PioBudny/Engineer-s-Thesis/README.md

# Engineer-s-Thesis
TDR project for my Engineer's Thesis
