PioBudny/Engineer-s-Thesis/Schematic.pdf

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
GPIO[3..0]

INTR
RESET

8T_OUT_1
8T_OUT_2

8TCLKP
8TCLKN

Poer/In&Out
TDR_Schematic_PB.SchDoc

SDA
SCL
GPIO[3..0]

RESET

8TCLKP
8TCLKN

8T_OUT_1
8T_OUT_2

INTR

MCU
8T49N241-999NLGI.SchDoc
Autor | Piotr Budny | Zmodyfikowano 14.05.2026 13:14:04

Temat pracy

Ark. główny
Ark. bieżący

/Altium/TDR/Main.SchDoc
Current Sheet

Promotor Dr. Inż. Maciej Urbański

Wersja *

Strona | Stron ogółem 1 | 3

Nr albumu 324985

Reflektometr do pomiarów parametrów linii długich

D D

C C

B B

A A

Autor | Piotr Budny | Zmodyfikowano 14.05.2026 13:14:04

Temat pracy

Current sheet

Wersja 1.1

Strona | Stron ogółem 2 | 3

Nr albumu 324985

Reflektometr do pomiarów parametrów linii długich

GND

Q0 | 1
Q0 | 2
Q1 | 3
Q1 | 4
GND | 5

D1 6

D0 7

VCC 8

U2 SN65EPT22DGKR

+3V3

TIMER_STM32

8T_CLK_N

8T_CLK_P

GND

GND
TIMER_STM32
SCL
SDA
GPIO0
GPIO1

GND

GND

GPIO2
GPIO3

GND
2

P1 1803426

IN 1
IN 2

EN/UV 3

ILIM | 5
OUT | 10
OUTS | 9
PG | 4
PGFB 6

SET 7

GND | 8
GND | 11

U1

LT3045EDD#PBF

GND

C1
10uF

GND

+5V

C3

DNM

GND

C2

### 10 uF

IN 1
IN 2

EN/UV 3

ILIM | 5
OUT | 10
OUTS | 9
PG | 4
PGFB 6

SET 7

GND | 8
GND | 11

U4

LT3045EDD#PBF

GND

C35
10uF

GND

+3V3

C41
DNM

GND

C36
10uF
GND | GND

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
P2 61300911121

1
2
3
4
5

J2

142-0701-851

4
5

J1

142-0701-851

1
2
3
4
5

J4

142-0701-851

D3 | D5 D4

GND

### 9 x AQ4020-01FTG

C5
10pF

C4
10pF

8T_OUT_1

ADC_CLK_N

ADC_CLK_P

ADC_CLK_P
ADC_CLK_N

R7
50

R8

### 50 R6

50

R9
100

R19
18.2K

R5
33.2K
D6 | D7 | D8 | D9 | D10 | D11

INTR
RESET

R18
0

R3
0

0V ... 0,8V

0V ... 0,8V

0V ... 1V

AC

AC

AC

### 50 Ω

50

### 50 Ω

Wyjście zegara do układu AD9515

Zanegowane wyjście zegara do układu AD9515

Wyjście reflektometru 350ps

R2
10k

R1
91k

0V ... 18V

GND

1
2
3
4
5

J3

142-0701-851

8T_OUT_2

0V ... 2,5V
AC 50

Wyjście reflektometru 240ps

1

4 3

Q1

DMP4015SK3-13

D2 TLMG¹¹⁰⁰⁻GS¹⁵

1

1

2

2

3

3
X1

Przełącznik włącz/wyłącz

C42

100uF

+5V

GND | GND

8TCLKP
8TCLKN
+1V8 | +3V3

8T_OUT_1

8T_OUT_2

SCL
SDA

INTR
RESET

GPIO[3..0]

D1

SMF5.0A-T13

C6
0.1uF

5MS1S102AM2QE

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
Kondensatory dołączone do dziur montażowych
MH1 | MH2 | MH3 | MH4

R4
1.2K

D D

C C

B B

A A

Autor | Piotr Budny | Zmodyfikowano 14.05.2026 13:14:04

Temat pracy

Current sheet

Wersja 1.1

Strona | Stron ogółem 3 | 3

Nr albumu 324985

Reflektometr do pomiarów parametrów linii długich

+3V3

+1V8

SDA
SCL

+3V3

INTR
RESET

+3V3

GND

GND

+3V3

C8
100pF

C10
100pF

C20
100pF

C22
100pF

C7
100pF

C9
100pF

C11
100pF

C21
100pF

GND

C24
10pF
Postawić blisko pinów VCC VCC ¹³ VCC ¹⁵ | VCCA

## 1 VCCA

### 2 VCCA 30 VCCA 32 VCCA 39 VCCCS 36

VCCO0 | 4
VCCO1 | 10
VCCO2 | 21
VCCO3 | 27

GPIO[0] 3

GPIO[1] 7

GPIO[2] 24 | GPIO[3] 28
*Q0 | 6
*Q1 | 8
*Q2 | 23
*Q3 | 25

CLK0 16

CLK1 18

NINT 29
NRST 31 | NWP 35

OSCI 33
OSCO 34
Q0 | 5
Q1 | 9
Q2 | 22
Q3 | 26
SCLK 12 | SDATA 11 | VEE 14

*CLK0 17

*CLK1 19

S_A0 40

S_A1 20 | CAP 37 CAP_REF 38 | EPAD 41

U3
8T49N241-998NLGI

GPIO3
GPIO2
GPIO1
GPIO0

R10
10K | R11
| 10K

R15
10K | R16
| 10K

ADDR: 0x7C+"S_A0"+"S_A1"

R13
DNM

R12
DNM

+3V3

C31
10pF

D12

TLMG1100-GS15

GND

+3V3

R17
600

R14
10K

GND

8TCLKP
8TCLKN

8T_OUT_1

8T_OUT_2

INTR
RESET

SDA
SCL

GPIO[3..0]

C27
10pF

C25
10pF

GND

Debug

Debug

+3V3

VCO1

VCO2

VCO3

C32

100pF

GND

C33

100pF

GND

C34

100pF

GND

VCO1 | VCO2 | VCO3

C16
0.1uF

C17
0.1uF

C18
0.1uF

C19
0.1uF

C15
0.1uF

C14
0.1uF

C13
0.1uF

C12
0.1uF

C28
0.1uF

C29
0.1uF

C38
0.1uF

C40
0.1uF

C37
0.1uF

+3V3

R21
0

R20
0

GND

NC XIN
XOUT NC

H130B-25.000-18-F-1030-EXT-TR X2
