PioBudny/Engineer-s-Thesis/Altium/TDR/TDR_BOM.xlsx

Name/Value | Description | Designator | Footprint/Package | Quantity | Manufacturer | Manufacturer Part Number | Supplier 1 | Supplier Part Number 1 | Supplier 2 | Supplier Part Number 2 | Supplier 3 | Supplier Part Number 4 | Remarks
10uF | Generic Capicitor | C1, C2 C35, C36 | SMD 0603 | 4 | KEMET | C0603C106M9PAC7411 | Mouser | 80-C0603C106M9P7411 | DigiKey | 399-C0603C106M9PAC7411TR-ND | Generic
DNM | Generic Capicitor | C3, C41 | SMD 0603 | 2 | DNM
10pF | Special Capicitor designed for high frequency | C4, C5, C24, C25, C27, C31 | SMD 0603 | 6 | KYOCERA AVX | KGQ15ACG2D100GT | Mouser | 581-KGQ15ACG2D100GT | DigiKey | 478-KGQ15ACG2D100GTTR-ND | arrow electronics | Cap Ceramic 10pF 200V C0G 2% Pad SMD 0603 125°C T/R
100nF | Low ESR Decoupling capacitor | C6, C12, C13, C14, C15, C16, C17, C18, C19,C28, C29, C37, C38, C40 C42 | SMD 0603 | 14 | KYOCERA AVX | KGM15AR70J104KT | Mouser | 581-KGM15AR70J104KT | DigiKey | 478-KGM15AR70J104KTTR-ND - | Generic Low ESR
100pF | Low ESR Decoupling capacitor | C7, C8, C9, C10, C11, C20, C21, C22, C32, C33, C34, | SMD 0603 | 11 | KYOCERA AVX | KGM15ACG2A101JM | Mouser | 581-KGM15ACG2A101JM | ElectroMaker | Multilayer Ceramic Capacitors MLCC - SMD/SMT 100V 100pF C0G 0603 5% | Generic Low ESR
100uF | THT bulk capacitor | C42 | THT | 1 | Kemet | ESK107M025AC3AA | Mouser | 80-ESK107M025AC3AA | DigiKey | 399-6102-ND | Newark | 87AC7446
SMF5.0A-T13 | TVS Diode (Uni-directional) | D1 | SOD-123-2 | 1 | Littelfuse | SMF5.0A-T13 | Mouser | 576-SMF5.0A-T13 | DigiKey | 18-SMF5.0A-T13TR-ND | Farnell | 2691565
TLMG1100-GS15 | Standard LEDs - SMD CHIPLED(SMD 0603-LED) GREEN U.BRIGHT-E4 | D2, D12 | SMD 0603 | 2 | Vishay | TLMG1100-GS15 | Mouser | 78-TLMG1100-GS15 | DigiKey | 751-TLMG1100-GS15TR-ND | TME | TLMG1100-GS15
AQ4020-01FTG | TVS Diode (Uni-directional) | D3, D4, D5, D6, D7, D8, D9, D10, D11 | SOD-323-2 | 9 | Littelfuse | AQ4020-01FTG | Mouser | 576-AQ4020-01FTG | DigiKey | F10395TR-ND | Arrow Electronics | ESD Suppressor Diode TVS Bi-Dir 3.3V 24.5Vc Automotive AEC-Q101 2-Pin SOD-323 T/R
142-0701-851 | SMA connector straight | J1, J2, J3, J4 | THT | 4 | 530-142-0701-851 | Cinch Connectivity Solutions | Available/DNM
DNM | Generic Capicitor | MH1, MH2, MH3, MH4 | SMD 0805 | 4 | DNM
1803426 | Male Header, Pitch 3.81 mm, 1 x 2 Position, Height 9.2 mm, Tail Length 3.4 mm | P1 | THT 3.8mm | 1 | Phoenix Contact | 1803426 | Mouser | 651-1803426 | DigiKey | 277-1221-ND | TME | MCV1.5/2-G-3.81
61300911121 | Generic THT Vertical Pin Header WR-PHD, Pitch 2.54 mm, Single Row, 9 pins | P2 | THT 2.54mm | 1 | Wurth Elektronik | 61300911121 | Mouser | 710-61300911121 | Farnell | 2356161 | Generic Goldpins 2.54mm rastr 9-10 pins
DMP4015SK3-13 | P-channel MOSFET transistor | Q1 | TO-252 | 1 | Diodes Incorporated | DMP4015SK3-13 | Mouser | 621-DMP4015SK3-13 | DigiKey | DMP4015SK3-13DITR-ND | Farnell | 2543554
91k | Generic Resistor | R1 | SMD 0805 | 1 | YAGEO | RC0805FR-0791KL | Mouser | 603-RC0805FR-0791KL | DigiKey | 311-91.0KCRTR-ND - Tape & Reel | Generic Resistor
0 | Generic Resistor | R3, R18, R20, R21 | SMD 0805 | 4 | YAGEO | AC0805FR-070RL | Mouser | 603-AC0805FR-070RL | DigiKey | 13-AC0805FR-070RLTR-ND | Generic Resistor
1.2K | Generic Resistor | R4 | SMD 0805 | 1 | YAGEO | AC0805FR-071K2L | Mouser | 603-AC0805FR-071K2L | DigiKey | YAG3700TR-ND | Generic Resistor
33.2K | Generic Resistor | R5 | SMD 0805 | 1 | YAGEO | AC0805FR-0733K2L | Mouser | 603-AC0805FR-0733K2L | DigiKey | 13-AC0805FR-0733K2LTR-ND | Generic Resistor
50 | Generic Resistor | R6, R7, R8 | SMD 0603 | 3 | Vishay Dale | RCP0603W50R0GEB | Mouser | 71-RCP0603W50R0GEB | DigiKey | 541-2655-2-ND | Generic Resistor
100 | Generic Resistor | R9 | SMD 0603 | 1 | YAGEO | RC0603FR-07100RL | Mouser | 603-RC0603FR-07100RL | DigiKey | 311-100HRTR-ND | Generic Resistor
10K | Generic Resistor | R2, R10, R11, R14, R15, R16 | SMD 0805 | 5 | YAGEO | RC0805FR-0710KL | Mouser | 603-RC0805FR-0710KL | DigiKey | 311-10.0KCRTR-ND | Generic Resistor
DNM | Generic Resistor | R12, R13 | SMD 0805 | 2 | DNM
600 | Generic Resistor | R17 | SMD 0603 | 1 | YAGEO | AC0603FR-07604RL | Mouser | 603-AC0603FR-07604RL | DigiKey | 13-AC0603FR-07604RLTR-ND | Generic Resistor
18.2K | Generic Resistor | R19 | SMD 0805 | 1 | YAGEO | RC0805FR-0718K2L | Mouser | 603-RC0805FR-0718K2L | DigiKey | 311-18.2KCRTR-ND | Generic Resistor
LT3045EDD#PBF | IC REG LINEAR 0V 500MA 10DFN | U1, U4 | DFN-10 | 2 | Analog Devices | LT3045EDD#PBF | Mouser | 584-LT3045EDD#PBF | DigiKey | 505-LT3045IDD#TRPBFTR-ND | Worldway Electronics | LT3045EDD#PBF-10484781
SN65EPT22DGKR | 4000 Mbps 3.3 V Dual LVTTL / LVCMOS to Differential LVPECL Buffer, 2 Tx and 2 Rx, -40 to +85 degC, 8-pin VSSOP (DGK), Green (RoHS & no Sb/Br) | U2 | 8-TSSOP | 1 | Texas Instruments | SN65EPT22DGKR | Mouser | 595-SN65EPT22DGKR | DigiKey | 296-46326-1-ND | Texas Industries | SN65EPT22DGKR
8T49N241-999NLGI | Tin Active e3 CLOCK GENERATOR OTHER (Type) IC 18Weeks -40C 6mm 1GHz | U3 | 40-VFQFN | 1 | Renesans electronics | 8T49N241-998NLGI | Mouser | 972-8T49N241-998NLGI | Farnell | 3251297 | RS | 8T49N241-998NLGI
5MS1S102AM2QE | Switch: Slide; Positions: 2; SPDT; 2A/250VAC; 5A/28VDC; ON-ON | X1 | THT 4.7mm | 1 | LIGHT COUNTRY CO., LTD | 5MS1S102AM2QE | TME | 5MS1S102AM2QE | Mouser | 118-5MS1S102AM2QES | Generic SPDT switch with 4.7mm raster and at least 5A/20V
H130B-25.000-12-F-EXT-TR | Crystal 25MHZ, 12pF 30, mohm | X2 | SMD | 1 | Raltron Electronics | H130B-25.000-12-F-EXT-TR | DigiKey | 2151-H130B-25.000-12-F-EXT-TR-ND | Newark | H130B-25.000-12-F-EXT-TR | - | -
