PioBudny/Engineer-s-Thesis/TEST/Newfile1.csv

X | CH1 | Start | Increment
Sequence | Volt | -7.000000e-08 | 1.000000e-10
0 | -4.687500e-01
1 | -4.687500e-01
2 | -4.687500e-01
3 | -4.687500e-01
4 | -3.125000e-01
5 | -3.125000e-01
6 | -3.125000e-01
7 | -3.125000e-01
8 | -4.687500e-01
9 | -4.687500e-01
10 | -3.125000e-01
11 | -3.125000e-01
12 | -4.687500e-01
13 | -4.687500e-01
14 | -4.687500e-01
15 | -4.687500e-01
16 | -3.125000e-01
17 | -3.125000e-01
18 | -4.687500e-01
19 | -4.687500e-01
20 | -4.687500e-01
21 | -4.687500e-01
22 | -4.687500e-01
23 | -4.687500e-01
24 | -4.687500e-01
25 | -4.687500e-01
26 | -4.687500e-01
27 | -4.687500e-01
28 | -4.687500e-01
29 | -4.687500e-01
30 | -4.687500e-01
31 | -4.687500e-01
32 | -3.125000e-01
33 | -3.125000e-01
34 | -3.125000e-01
35 | -3.125000e-01
36 | -4.687500e-01
37 | -4.687500e-01
38 | -4.687500e-01
39 | -4.687500e-01
40 | -4.687500e-01
41 | -4.687500e-01
42 | -4.687500e-01
43 | -4.687500e-01
44 | -4.687500e-01
45 | -4.687500e-01
46 | -4.687500e-01
47 | -4.687500e-01
48 | -4.687500e-01
49 | -4.687500e-01
50 | -4.687500e-01
51 | -4.687500e-01
52 | -6.250000e-01
53 | -6.250000e-01
54 | -4.687500e-01
55 | -4.687500e-01
56 | -4.687500e-01
57 | -4.687500e-01
58 | -4.687500e-01
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
