PioBudny/Engineer-s-Thesis/TEST/TDR_pulse_50-120-50_open_1.csv

X | CH1 | Start | Increment
Sequence | Volt | -2.000000e-10 | 1.000000e-11
0 | 0.000000e+00
1 | 0.000000e+00
2 | 0.000000e+00
3 | 0.000000e+00
4 | 0.000000e+00
5 | 0.000000e+00
6 | 0.000000e+00
7 | 0.000000e+00
8 | 0.000000e+00
9 | 0.000000e+00
10 | 0.000000e+00
11 | 0.000000e+00
12 | 0.000000e+00
13 | 0.000000e+00
14 | 0.000000e+00
15 | 0.000000e+00
16 | 0.000000e+00
17 | 0.000000e+00
18 | 0.000000e+00
19 | 0.000000e+00
20 | 0.000000e+00
21 | 7.500000e-02
22 | 1.500000e-01
23 | 2.250000e-01
24 | 3.000000e-01
25 | 3.750000e-01
26 | 4.500000e-01
27 | 5.250000e-01
28 | 6.000000e-01
29 | 6.750000e-01
30 | 7.500000e-01
31 | 8.250000e-01
32 | 9.000000e-01
33 | 9.750000e-01
34 | 1.050000e+00
35 | 1.125000e+00
36 | 1.200000e+00
37 | 1.275000e+00
38 | 1.350000e+00
39 | 1.425000e+00
40 | 1.500000e+00
41 | 1.425000e+00
42 | 1.350000e+00
43 | 1.275000e+00
44 | 1.200000e+00
45 | 1.125000e+00
46 | 1.050000e+00
47 | 9.750000e-01
48 | 9.000000e-01
49 | 8.250000e-01
50 | 7.500000e-01
51 | 6.750000e-01
52 | 6.000000e-01
53 | 5.250000e-01
54 | 4.500000e-01
55 | 3.750000e-01
56 | 3.000000e-01
57 | 2.250000e-01
58 | 1.500000e-01
59 | 7.500000e-02
60 | 3.330669e-16
61 | 0.000000e+00
62 | 0.000000e+00
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
