PioBudny/Engineer-s-Thesis/TEST/test1.csv

X | CH1 | Start | Increment
Sequence | Volt | -1.919999e-09 | 2.000000e-11
0 | -4.687500e-01
1 | -4.687500e-01
2 | -4.687500e-01
3 | -4.687500e-01
4 | -4.687500e-01
5 | -4.687500e-01
6 | -4.687500e-01
7 | -4.687500e-01
8 | -4.687500e-01
9 | -4.687500e-01
10 | -4.687500e-01
11 | -4.687500e-01
12 | -4.687500e-01
13 | -4.687500e-01
14 | -4.687500e-01
15 | -4.687500e-01
16 | -4.687500e-01
17 | -4.687500e-01
18 | -4.687500e-01
19 | -4.687500e-01
20 | -4.687500e-01
21 | -4.687500e-01
22 | -4.687500e-01
23 | -4.687500e-01
24 | -4.687500e-01
25 | -4.687500e-01
26 | -4.687500e-01
27 | -4.687500e-01
28 | -6.250000e-01
29 | -6.250000e-01
30 | -6.250000e-01
31 | -6.250000e-01
32 | -6.250000e-01
33 | -6.250000e-01
34 | -6.250000e-01
35 | -6.250000e-01
36 | -6.250000e-01
37 | -6.250000e-01
38 | -6.250000e-01
39 | -6.250000e-01
40 | -6.250000e-01
41 | -6.250000e-01
42 | -6.250000e-01
43 | -6.250000e-01
44 | -6.250000e-01
45 | -6.250000e-01
46 | -6.250000e-01
47 | -6.250000e-01
48 | -6.250000e-01
49 | -6.250000e-01
50 | -6.250000e-01
51 | -6.250000e-01
52 | -6.250000e-01
53 | -6.250000e-01
54 | -6.250000e-01
55 | -6.250000e-01
56 | -6.250000e-01
57 | -6.250000e-01
58 | -6.250000e-01
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
