PioBudny/Engineer-s-Thesis/TEST/test3.csv

X | CH1 | Start | Increment
Sequence | Volt | -1.440000e-08 | 5.000000e-11
0 | -3.125000e-01
1 | -3.125000e-01
2 | -3.750000e-01
3 | -3.750000e-01
4 | -3.125000e-01
5 | -3.125000e-01
6 | -3.125000e-01
7 | -3.125000e-01
8 | -3.125000e-01
9 | -3.125000e-01
10 | -3.125000e-01
11 | -3.125000e-01
12 | -3.750000e-01
13 | -3.750000e-01
14 | -3.125000e-01
15 | -3.125000e-01
16 | -3.750000e-01
17 | -3.750000e-01
18 | -3.750000e-01
19 | -3.750000e-01
20 | -3.750000e-01
21 | -3.750000e-01
22 | -3.750000e-01
23 | -3.750000e-01
24 | -3.750000e-01
25 | -3.750000e-01
26 | -3.750000e-01
27 | -3.750000e-01
28 | -3.750000e-01
29 | -3.750000e-01
30 | -3.750000e-01
31 | -3.750000e-01
32 | -3.750000e-01
33 | -3.750000e-01
34 | -3.750000e-01
35 | -3.750000e-01
36 | -3.750000e-01
37 | -3.750000e-01
38 | -3.750000e-01
39 | -3.750000e-01
40 | -3.125000e-01
41 | -3.125000e-01
42 | -3.750000e-01
43 | -3.750000e-01
44 | -3.125000e-01
45 | -3.125000e-01
46 | -3.125000e-01
47 | -3.125000e-01
48 | -3.125000e-01
49 | -3.125000e-01
50 | -3.125000e-01
51 | -3.125000e-01
52 | -3.750000e-01
53 | -3.750000e-01
54 | -3.125000e-01
55 | -3.125000e-01
56 | -3.750000e-01
57 | -3.750000e-01
58 | -3.750000e-01
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
