PioBudny/Engineer-s-Thesis/(list of files, drawings)

Other design files:
Altium/TDR/8T49N241-999NLGI.SchDoc
Altium/TDR/Main.SchDoc
Altium/TDR/TDR3.PcbDoc
Altium/TDR/TDR.PrjPcb
Altium/TDR/TDR_PCB_1.PcbLib
Altium/TDR/TDR_Sch_1.SchLib
Altium/TDR/TDR_Schematic_PB.SchDoc
Altium/TDR/Test.PcbDoc
