PioBudny/Engineer-s-Thesis/TDR_software/src/8T49N241/8T49N241.c

#include "8T49N241.h"
#include "pico/stdlib.h"
#include <stdlib.h>
#include <stdio.h>
#include <string.h>

void i2c_device_init(i2c_inst_t *i2c, uint sda, uint scl) {
    i2c_init(i2c, 400 * 1000);
    gpio_set_function(sda, GPIO_FUNC_I2C);
    gpio_set_function(scl, GPIO_FUNC_I2C);
    gpio_pull_up(sda);
    gpio_pull_up(scl);

    sleep_ms(200);
}


bool i2c_write_reg16(i2c_inst_t *i2c, uint8_t addr, uint16_t reg, uint8_t *data, size_t len) {
    uint8_t buffer[258];

    buffer[0] = (reg >> 8) & 0xFF;
    buffer[1] = reg & 0xFF;

    for (size_t i = 0; i < len; i++) {
        buffer[2 + i] = data[i];
    }

    int ret = i2c_write_timeout_us(i2c, addr, buffer, len + 2, false, 1000000); // 1s timeout
    return (ret >= 0);
}


bool i2c_read_reg16(i2c_inst_t *i2c, uint8_t addr, uint16_t reg, uint8_t *data, size_t len) {
    uint8_t reg_buf[2];

    reg_buf[0] = (reg >> 8) & 0xFF;
    reg_buf[1] = reg & 0xFF;

    // ustaw adres rejestru
    if (i2c_write_timeout_us(i2c, addr, reg_buf, 2, true, 1000000) < 0) { // 1s timeout
        return false;
    }

    // czytaj dane
    if (i2c_read_timeout_us(i2c, addr, data, len, false, 1000000) < 0) { // 1s timeout
        return false;
    }

    return true;
}

const NLG_cfg_t Default_values[] =
{
    {0x0000, 0x09},
    {0x0001, 0x50},
  
    {0x0008, 0x03},
    {0x0009, 0x00},
    {0x000A, 0x31},
    {0x000B, 0x00},
    {0x000C, 0x00},
    {0x000D, 0x00},
    {0x000E, 0x00},
    {0x000F, 0x00},
    {0x0010, 0x01},
    {0x0011, 0x00},
    {0x0012, 0x00},
    {0x0013, 0x00},
    {0x0014, 0x07},
    {0x0015, 0x00},
    {0x0016, 0x00},
    {0x0017, 0x77},
    {0x0018, 0x6D},
    {0x0019, 0x00},
    {0x001A, 0x00},
    {0x001B, 0x00},
    {0x001C, 0x00},
    {0x001D, 0x00},
    {0x001E, 0x00},
    {0x001F, 0xFF},
    {0x0020, 0xFF},
    {0x0021, 0xFF},
    {0x0022, 0xFF},
    {0x0023, 0x03},
    {0x0024, 0x3F},
    {0x0025, 0x00},
    {0x0026, 0x46},

    {0x0027, 0x00},
    {0x0028, 0x00},
    {0x0029, 0x00},
    {0x002A, 0x00},
    {0x002B, 0x00},
    {0x002C, 0x01},
    {0x002D, 0x00},
    {0x002E, 0x00},
    {0x002F, 0xD0},
    {0x0030, 0x00},
    {0x0031, 0x00},
    {0x0032, 0x00},
    {0x0033, 0x00},
    {0x0034, 0x00},
    {0x0035, 0x00},
    {0x0036, 0x00},
    {0x0037, 0x00},
    {0x0038, 0x00},

    {0x003A, 0x00},
    {0x003B, 0x00},
    {0x003C, 0x00},
    {0x003D, 0x66},
    {0x003E, 0x66},
    {0x003F, 0x00},
    {0x0040, 0x00},
    {0x0041, 0x03},
    {0x0042, 0x00},
    {0x0043, 0x00},
    {0x0044, 0x03},
    {0x0045, 0x00},
    {0x0046, 0x04},
    {0x0047, 0xE2},

    {0x0048, 0x00},
    {0x0049, 0x04},
    {0x004A, 0xE2},

    {0x004B, 0x00},
    {0x004C, 0x00},
    {0x004D, 0x00},
    {0x004E, 0x00},
    {0x004F, 0x00},
    {0x0050, 0x00},
    {0x0051, 0x00},
    {0x0052, 0x00},
    {0x0053, 0x00},
    {0x0054, 0x00},
    {0x0055, 0x00},
    {0x0056, 0x00},
    {0x0057, 0x00},
    {0x0058, 0x00},
    {0x0059, 0x00},
    {0x005A, 0x00},
    {0x005B, 0x00},
    {0x005C, 0x00},
    {0x005D, 0x00},
    {0x005E, 0x00},
    {0x005F, 0x00},
    {0x0060, 0x00},
    {0x0061, 0x00},
    {0x0062, 0x00},
    {0x0063, 0x33},

    {0x0064, 0x00},
    {0x0065, 0x00},
    {0x0066, 0x00},
    {0x0067, 0x00},
    {0x0068, 0xE8},
    {0x0069, 0x0A},

    {0x006A, 0x2B},
    {0x006B, 0x20},
    {0x006C, 0x00},
    {0x006D, 0x03},
    {0x006E, 0x00},
    {0x006F, 0x03},

    {0x0070, 0x00},
    {0x0071, 0x00},
    {0x0072, 0x00},
    {0x0072, 0x17},
    {0x0073, 0x17},
    {0x0074, 0x00},
    {0x0075, 0x00},
    {0x0076, 0x00},
    {0x0077, 0x00},
    {0x0078, 0x00},
    {0x0079, 0x00},

    {0x007A, 0x27},
    {0x007B, 0xCC},
    {0x0200, 0x73},
};

const NLG_cfg_t Debug_values[] =
{
    {0x0000, 0x09},
    {0x0001, 0x50},
    {0x0002, 0x00},
    {0x0003, 0x60},
    {0x0004, 0x67},
    {0x0005, 0xCF},
    {0x0006, 0x7C},
    {0x0007, 0x01},
    {0x0008, 0x03},
    {0x0009, 0x00},
    {0x000A, 0x31},
    {0x000B, 0x00},
    {0x000C, 0x00},
    {0x000D, 0x00},
    {0x000E, 0x00},
    {0x000F, 0x00},
    {0x0010, 0x01},
    {0x0011, 0x00},
    {0x0012, 0x00},
    {0x0013, 0x00},
    {0x0014, 0x07},
    {0x0015, 0x00},
    {0x0016, 0x00},
    {0x0017, 0x77},
    {0x0018, 0x6D},
    {0x0019, 0x00},
    {0x001A, 0x00},
    {0x001B, 0x00},
    {0x001C, 0x00},
    {0x001D, 0x00},
    {0x001E, 0x00},
    {0x001F, 0xFF},
    {0x0020, 0xFF},
    {0x0021, 0xFF},
    {0x0022, 0xFF},
    {0x0023, 0x03},
    {0x0024, 0x3F},
    {0x0025, 0x00},
    {0x0026, 0x46},
    {0x0027, 0x00},
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
};

const size_t Debug_values_count = sizeof(Debug_values) / sizeof(Debug_values[0]);
const size_t Default_values_count = sizeof(Default_values) / sizeof(Default_values[0]);

void Flag_Clear(i2c_inst_t *i2c)
{
    uint8_t clr = 0x73;
    i2c_write_reg16(i2c, DEVICE_ADDR, REG_INT_STATUS_0, &clr, 1);
}

void dump_all_regs(i2c_inst_t *i2c)
{
    uint8_t data;

    printf("\n==============================\n");
    printf("8T49N241 regs:\n");
    printf("==============================\n");


    // ========================================
    // REJESTRY KONFIGURACYJNE
    // 0x0000 - 0x007B
    // ========================================

    for(uint16_t reg = 0x0000;
        reg <= 0x007B;
        reg++)
    {
        if(i2c_read_reg16(
            i2c,
            DEVICE_ADDR,
            reg,
            &data,
            1
        ))
        {
            printf(
                "REG[0x%04X] = 0x%02X\n",
                reg,
                data
            );
        }
        else
        {
            printf(
                "REG[0x%04X] = READ ERROR\n",
                reg
            );
        }

        sleep_us(100);
    }


    // ========================================
    // REJESTRY STATUSOWE
    // 0x0200 - 0x0212
    // ========================================

    printf("\nSTATUS REGS\n\n");

    for(uint16_t reg = 0x0200;
        reg <= 0x0212;
        reg++)
    {
        if(i2c_read_reg16(
            i2c,
            DEVICE_ADDR,
            reg,
            &data,
            1
        ))
        {
            printf(
                "REG[0x%04X] = 0x%02X\n",
                reg,
                data
            );
        }
        else
        {
            printf(
                "REG[0x%04X] = READ ERROR\n",
                reg
            );
        }

        sleep_us(100);
    }
}


bool load_tab(i2c_inst_t *i2c, const NLG_cfg_t *cfg, size_t count)
{
    printf("Loading config...\n");

    for (size_t i = 0; i < count; i++)
    {
        uint16_t reg = cfg[i].reg;
        uint8_t value = cfg[i].value;

        // Próba zapisu rejestru
        if (!i2c_write_reg16(i2c, DEVICE_ADDR, reg, &value, 1))
        {
            sleep_ms(2); 
            if (!i2c_write_reg16(i2c, DEVICE_ADDR, reg, &value, 1)) {
                printf("Skip reg 0x%04X\n", reg);
                continue;
            }
        }


    }

    printf("Config loaded successfully\n");
    sleep_ms(10);
    return true;
}
