PioBudny/Engineer-s-Thesis/TDR_software/src/Impedance_wave.py

import tkinter as tk
import csv
import bisect
from pathlib import Path
from tkinter import filedialog, messagebox
from tkinter import ttk

SCOPE_RIGOL = "DS4052 Rigol"
SCOPE_RS = "RTO2044 Rohde&Schwarz"


def detect_trigger_index(values):
    """Auto-detects which sample corresponds to the scope's trigger point
    (t=0): the peak of the first pulse that rises clearly above the
    baseline noise. Used when compiling a raw .wfm.csv (one voltage value
    per line, no timing info) from the RTO2044 into the .csv format this
    calculator expects."""

    def average(nums):
        return sum(nums) / len(nums)

    prelim_count = max(3, int(len(values) * 0.05))
    prelim_offset = average(values[:prelim_count])
    corrected = [v - prelim_offset for v in values]
    noise = average([abs(v) for v in corrected[:prelim_count]])
    peak = max(abs(v) for v in corrected)
    threshold = max(noise * 6, peak * 0.1, 1e-12)

    start_index = None
    for i, v in enumerate(corrected):
        if abs(v) >= threshold:
            start_index = i
            break
    if start_index is None:
        return 0

    peak_index = start_index
    peak_magnitude = abs(corrected[start_index])
    for i in range(start_index, len(corrected)):
        magnitude = abs(corrected[i])
        if magnitude < threshold:
            break
        if magnitude > peak_magnitude:
            peak_magnitude = magnitude
            peak_index = i

    return peak_index


def Impedance_Wave(root, close_impedance_window):
    root.update_idletasks()
    root_x = root.winfo_x()
    root_y = root.winfo_y()
    root_w = root.winfo_width()

    impedance_window = tk.Toplevel(root)
    impedance_window.title("Impedance Calculator")
    impedance_window.geometry(f"1100x620+{root_x + root_w + 10}+{root_y}")
    impedance_window.protocol("WM_DELETE_WINDOW", close_impedance_window)

    # ────────────────────────────────────────────────────────────────
    # Górny pasek
    # ────────────────────────────────────────────────────────────────

    top_frame = tk.Frame(impedance_window)
    top_frame.pack(fill=tk.X, padx=10, pady=8)
    top_frame.columnconfigure(0, weight=1)

    csv_frame = tk.Frame(top_frame)
    csv_frame.grid(row=0, column=0, sticky="new", padx=(0, 10), pady=(0, 4))

    csv_path = tk.StringVar()
    z0_var = tk.StringVar(value="50")
    param_type_var = tk.StringVar(value="VF")
    param_value_var = tk.StringVar(value="")
    scope_var = tk.StringVar(value=SCOPE_RIGOL)
    rto_increment_var = tk.StringVar()
    raw_selected_path_var = tk.StringVar()  # file picked via Browse, before any RTO2044 compiling

    tk.Label(csv_frame, text="CSV file:").pack(side=tk.LEFT)

    tk.Entry(
        csv_frame,
        textvariable=csv_path
    ).pack(side=tk.LEFT, fill=tk.X, expand=True, padx=5)

    def prompt_rto_increment(blocking=False):
        prompt = tk.Toplevel(impedance_window)
        prompt.title("RTO2044 Increment")
        prompt.geometry("280x110")

        tk.Label(prompt, text="Increment (ps):", anchor="w").pack(fill=tk.X, padx=10, pady=(10, 4))
        entry_var = tk.StringVar(value=rto_increment_var.get())
        entry = tk.Entry(prompt, textvariable=entry_var)
        entry.pack(fill=tk.X, padx=10)
        entry.focus_set()

        def confirm():
            rto_increment_var.set(entry_var.get())
            prompt.destroy()

        tk.Button(prompt, text="OK", command=confirm).pack(pady=10)
        prompt.protocol("WM_DELETE_WINDOW", prompt.destroy)

        if blocking:
            prompt.grab_set()
            impedance_window.wait_window(prompt)

    def compile_wfm_to_csv(wfm_filename, increment_s):
        """Converts a raw .wfm.csv (one voltage value per line, no timing
        info) into the .csv format this calculator expects, writing it next
        to the source file. Raises OSError/ValueError on failure."""
        with open(wfm_filename, newline="") as wfm_file:
            raw_lines = [line.strip() for line in wfm_file if line.strip()]

        if not raw_lines:
            raise ValueError("The .wfm.csv file contains no data.")

        try:
            values = [float(v) for v in raw_lines]
        except ValueError:
            raise ValueError("The .wfm.csv file must contain one numeric value per line.")

        # Sample 0 in the file isn't necessarily t=0 - the scope's trigger
        # (t=0) usually sits somewhere in the middle of the capture, with
        # pre-trigger samples before it. Detect it automatically from the
        # waveform instead of asking for it.
        trigger_index = detect_trigger_index(values)
        start_s = -trigger_index * increment_s

        wfm_file_path = Path(wfm_filename)
        output_name = wfm_file_path.name
        if output_name.lower().endswith(".wfm.csv"):
            output_name = output_name[: -len(".wfm.csv")] + ".csv"
        else:
            output_name = wfm_file_path.stem + ".csv"
        output_path = wfm_file_path.parent / output_name

        with open(output_path, "w", newline="") as out_file:
            writer = csv.writer(out_file)
            writer.writerow(["X", "CH1", "Start", "Increment", ""])
            writer.writerow(["Sequence", "Volt", f"{start_s:.6e}", f"{increment_s:.6e}", ""])
            for index, value in enumerate(raw_lines):
                writer.writerow([index, value, ""])

        return output_path

    def load_from_scope(source_path):
        """Prepares source_path for loading according to the currently
        selected oscilloscope. For RTO2044 this asks for the increment
        (only here, right before it's needed) and compiles the raw
        .wfm.csv. Returns the path to actually load, or None on
        failure/cancel."""
        if scope_var.get() != SCOPE_RS:
            return source_path

        if not rto_increment_var.get().strip():
            prompt_rto_increment(blocking=True)

        try:
            increment_ps = float(rto_increment_var.get())
        except ValueError:
            messagebox.showerror("Invalid increment", "Increment (ps) must be numeric.")
            return None

        try:
            output_path = compile_wfm_to_csv(source_path, increment_ps * 1e-12)
        except (OSError, ValueError) as e:
            messagebox.showerror(".wfm.csv error", str(e))
            return None

        return str(output_path)

    def browse_csv():
        # File first, oscilloscope second - Browse doesn't need to know
        # which scope produced the file; that's decided when Load .csv
        # runs, based on whatever is selected in the scope list at that time.
        filename = filedialog.askopenfilename(
            title="Select measurement file",
            filetypes=[
                ("CSV files", "*.csv"),
                ("WFM CSV files", "*.wfm.csv"),
                ("All files", "*.*"),
            ],
        )

        if filename:
            raw_selected_path_var.set(filename)
            csv_path.set(filename)

    settings_frame = tk.Frame(top_frame)
    settings_frame.grid(row=1, column=0, sticky="new", padx=(0, 10))

    tk.Label(settings_frame, text="Z0 (Ohm):").pack(side=tk.LEFT)
    tk.Entry(settings_frame, textvariable=z0_var, width=8).pack(side=tk.LEFT, padx=(4, 12))

    tk.Label(settings_frame, text="Parameter:").pack(side=tk.LEFT, padx=(12, 4))

    def on_param_type_change(event=None):
        param_value_var.set("")

    param_combo = ttk.Combobox(
        settings_frame,
        textvariable=param_type_var,
        values=["VF", "ER"],
        state="readonly",
        width=6
    )
    param_combo.pack(side=tk.LEFT, padx=(0, 8))
    param_combo.bind("<<ComboboxSelected>>", on_param_type_change)

    tk.Entry(settings_frame, textvariable=param_value_var, width=8).pack(side=tk.LEFT, padx=(0, 12))

    variables_text = (
        "Z0 - reference impedance, VF - velocity factor (0-1), ER - relative permittivity (>1). "
    )
    tk.Label(
        settings_frame,
        text=variables_text,
        anchor="w",
        justify=tk.LEFT,
        wraplength=520
    ).pack(side=tk.LEFT, fill=tk.X, expand=True)
    
    
    # ────────────────────────────────────────────────────────────────
    # Vf/ER conversion
    # ────────────────────────────────────────────────────────────────
    def param_to_vf(param_type, value):
        if param_type == "VF":
            vf = value
            if vf > 1:
                vf /= 100
            if not (0 < vf <= 1):
                raise ValueError("VF must be between 0 and 1, or percent value like 66.")
            return vf
        else:  # ER
            er = value
            if er <= 1:
                raise ValueError("ER must be greater than 1.")
            return 1.0 / (er ** 0.5)
        
        
    # ────────────────────────────────────────────────────────────────
    # How To Use
    # ────────────────────────────────────────────────────────────────
    
    howto_text = (
        "How to use: 1) Browse and select the file  →  2) select the "
        "oscilloscope that produced it (DS4052 Rigol or RTO2044 "
        "Rohde&Schwarz)  →  3) Load .csv  →  4) set Z0 and VF/ER (add "
        "segments on the right if the cable has different sections)  →  "
        "5) Calculate Z(d)."
    )
    tk.Label(
        impedance_window,
        text=howto_text,
        anchor="w",
        justify=tk.LEFT,
        fg="gray",
        wraplength=1080
    ).pack(fill=tk.X, padx=10, pady=(0, 8))


    info_var = tk.StringVar(value="")

    content_frame = tk.Frame(impedance_window)
    content_frame.pack(fill=tk.BOTH, expand=True, padx=10, pady=(0, 10))

    charts_frame = tk.Frame(content_frame)
    charts_frame.pack(side=tk.LEFT, fill=tk.BOTH, expand=True)

    raw_chart_frame = tk.Frame(charts_frame, relief=tk.SUNKEN, borderwidth=1)
    raw_chart_frame.pack(side=tk.LEFT, fill=tk.BOTH, expand=True, padx=(0, 5))

    impedance_chart_frame = tk.Frame(charts_frame, relief=tk.SUNKEN, borderwidth=1)
    impedance_chart_frame.pack(side=tk.LEFT, fill=tk.BOTH, expand=True, padx=(5, 0))

    raw_canvas = tk.Canvas(raw_chart_frame, bg="white")
    raw_canvas.pack(fill=tk.BOTH, expand=True)

    impedance_canvas = tk.Canvas(impedance_chart_frame, bg="white")
    impedance_canvas.pack(fill=tk.BOTH, expand=True)

    math_frame = tk.Frame(content_frame, width=260)
    math_frame.pack(side=tk.RIGHT, fill=tk.Y, padx=(10, 0))
    math_frame.pack_propagate(False)


    # ────────────────────────────────────────────────────────────────
    # Segments with different VF/ER
    # ────────────────────────────────────────────────────────────────
    tk.Label(
        math_frame,
        text="Segments with different Vf/ER",
        anchor="w",
        justify=tk.LEFT,
        font=("Arial", 8, "bold"),
        wraplength=240
    ).pack(fill=tk.X, pady=(0, 4))

    segments_list = []  # [{"start": float, "end": float, "param_type": "VF"/"ER", "param_value": float}, ...]

    segments_tree = ttk.Treeview(
        math_frame,
        columns=("start", "end", "type", "value"),
        show="headings",
        height=8
    )
    segments_tree.heading("start", text="Start (m)")
    segments_tree.heading("end", text="End (m)")
    segments_tree.heading("type", text="Typ")
    segments_tree.heading("value", text="Wartosc")
    segments_tree.column("start", width=55, anchor="center")
    segments_tree.column("end", width=55, anchor="center")
    segments_tree.column("type", width=40, anchor="center")
    segments_tree.column("value", width=60, anchor="center")
    segments_tree.pack(fill=tk.X, pady=(0, 6))

    seg_start_var = tk.StringVar()
    seg_end_var = tk.StringVar()
    seg_type_var = tk.StringVar(value="VF")
    seg_value_var = tk.StringVar()

    seg_row1 = tk.Frame(math_frame)
    seg_row1.pack(fill=tk.X, pady=(0, 2))
    tk.Label(seg_row1, text="Start:", width=5, anchor="w").pack(side=tk.LEFT)
    tk.Entry(seg_row1, textvariable=seg_start_var, width=7).pack(side=tk.LEFT, padx=(0, 6))
    tk.Label(seg_row1, text="End:", width=4, anchor="w").pack(side=tk.LEFT)
    tk.Entry(seg_row1, textvariable=seg_end_var, width=7).pack(side=tk.LEFT)

    seg_row2 = tk.Frame(math_frame)
    seg_row2.pack(fill=tk.X, pady=(0, 4))
    seg_type_combo = ttk.Combobox(
        seg_row2,
        textvariable=seg_type_var,
        values=["VF", "ER"],
        state="readonly",
        width=5
    )
    seg_type_combo.pack(side=tk.LEFT)
    tk.Entry(seg_row2, textvariable=seg_value_var, width=9).pack(side=tk.LEFT, padx=(6, 0))

    seg_buttons_frame = tk.Frame(math_frame)
    seg_buttons_frame.pack(fill=tk.X, pady=(0, 8))



        
    # ────────────────────────────────────────────────────────────────
    # Segments logistics
    # ────────────────────────────────────────────────────────────────
    
    def refresh_segments_tree():
        segments_tree.delete(*segments_tree.get_children())
        for i, seg in enumerate(sorted(segments_list, key=lambda s: s["start"])):
            segments_tree.insert(
                "", "end", iid=str(i),
                values=(
                    f"{seg['start']:.3f}",
                    f"{seg['end']:.3f}",
                    seg["param_type"],
                    f"{seg['param_value']:.4g}"
                )
            )

    def on_add_segment():
        try:
            start = float(seg_start_var.get())
            end = float(seg_end_var.get())
            value = float(seg_value_var.get())
        except ValueError:
            messagebox.showerror("Segment error", "Start, End i Wartosc musza byc liczbami.")
            return

        if start < 0 or end <= start:
            messagebox.showerror("Segment error", "Musi byc: 0 <= Start < End.")
            return

        param_type = seg_type_var.get()

        try:
            param_to_vf(param_type, value)  # tylko walidacja
        except ValueError as e:
            messagebox.showerror("Segment error", str(e))
            return

        # Sprawdz nakladanie sie z istniejacymi segmentami
        for seg in segments_list:
            if start < seg["end"] and end > seg["start"]:
                messagebox.showerror(
                    "Segment error",
                    f"Zakres {start:g}-{end:g} m naklada sie z istniejacym "
                    f"segmentem {seg['start']:g}-{seg['end']:g} m."
                )
                return

        segments_list.append({
            "start": start,
            "end": end,
            "param_type": param_type,
            "param_value": value
        })

        seg_start_var.set("")
        seg_end_var.set("")
        seg_value_var.set("")

        refresh_segments_tree()

    def on_remove_segment():
        selection = segments_tree.selection()
        if not selection:
            messagebox.showwarning("No selection", "Zaznacz segment do usuniecia.")
            return

        sorted_segments = sorted(segments_list, key=lambda s: s["start"])
        indices_to_remove = sorted((int(iid) for iid in selection), reverse=True)

        for idx in indices_to_remove:
            segments_list.remove(sorted_segments[idx])

        refresh_segments_tree()

    def on_clear_segments():
        if not segments_list:
            return
        if messagebox.askyesno("Clear segments", "Usunac wszystkie segmenty?"):
            segments_list.clear()
            refresh_segments_tree()

    tk.Button(seg_buttons_frame, text="Add", width=7, command=on_add_segment).pack(side=tk.LEFT, padx=(0, 4))
    tk.Button(seg_buttons_frame, text="Remove", width=7, command=on_remove_segment).pack(side=tk.LEFT, padx=(0, 4))
    tk.Button(seg_buttons_frame, text="Clear", width=7, command=on_clear_segments).pack(side=tk.LEFT)
    
    # ────────────────────────────────────────────────────────────────
    # Charts
    # ────────────────────────────────────────────────────────────────
    
    raw_data = {
        "x_values": [],
        "y_values": [],
        "x_label": "Time (s)",
        "y_label": "Voltage (V)",
        "title": "Raw CSV data",
        "x_min": None,
        "x_max": None,
        "y_min": None,
        "y_max": None,
        "pan_start": None,
        "redraw_job": None
    }

    impedance_data = {
        "x_values": [],
        "y_values": [],
        "x_label": "Distance (m)",
        "y_label": "Impedance (Ohm)",
        "title": "Impedance Profile",
        "x_min": None,
        "x_max": None,
        "y_min": None,
        "y_max": None,
        "pan_start": None,
        "redraw_job": None
    }

    def bind_mouse_wheel(canvas, chart_data):
        canvas.bind("<MouseWheel>", lambda event: on_mouse_wheel(event, canvas, chart_data))
        canvas.bind("<Button-4>", lambda event: on_mouse_wheel(event, canvas, chart_data))
        canvas.bind("<Button-5>", lambda event: on_mouse_wheel(event, canvas, chart_data))
        canvas.bind("<ButtonPress-1>", lambda event: on_pan_start(event, canvas, chart_data))
        canvas.bind("<B1-Motion>", lambda event: on_pan_move(event, canvas, chart_data))
        canvas.bind("<ButtonRelease-1>", lambda event: on_pan_end(event, canvas, chart_data))

    bind_mouse_wheel(raw_canvas, raw_data)
    bind_mouse_wheel(impedance_canvas, impedance_data)

    PLOT_PAD_L, PLOT_PAD_R, PLOT_PAD_T, PLOT_PAD_B = 60, 20, 30, 50
    _NO_REFERENCE_LINE = object()

    def update_chart_bounds(chart_data, x_values, y_values, reference_line, reset_bounds=False):
        if reset_bounds or chart_data.get("x_min") is None:
            if not x_values or not y_values:
                chart_data["x_min"] = 0.0
                chart_data["x_max"] = 1.0
                if reference_line is not None:
                    chart_data["y_min"] = reference_line - max(abs(reference_line) * 0.1, 1.0)
                    chart_data["y_max"] = reference_line + max(abs(reference_line) * 0.1, 1.0)
                else:
                    chart_data["y_min"] = 0.0
                    chart_data["y_max"] = 1.0
                return

            min_x = min(x_values)
            max_x = max(x_values)
            min_y = min(y_values)
            max_y = max(y_values)

            if reference_line is not None:
                min_y = min(min_y, reference_line)
                max_y = max(max_y, reference_line)

            if min_x == max_x:
                min_x -= 1
                max_x += 1

            margin_y = (max_y - min_y) * 0.1 or 5
            min_y -= margin_y
            max_y += margin_y

            chart_data["x_min"] = min_x
            chart_data["x_max"] = max_x
            chart_data["y_min"] = min_y
            chart_data["y_max"] = max_y

    def draw_chart(canvas, chart_data, x_values, y_values, title,
                   x_label, y_label, empty_text,
                   reference_line=_NO_REFERENCE_LINE,
                   reference_line_label=None,
                   reset_bounds=False):
        if reference_line is _NO_REFERENCE_LINE:
            reference_line = chart_data.get("reference_line")
            reference_line_label = chart_data.get("reference_line_label")
        elif reference_line is None:
            chart_data.pop("reference_line", None)
            chart_data.pop("reference_line_label", None)
        else:
            chart_data["reference_line"] = reference_line
            chart_data["reference_line_label"] = reference_line_label
        chart_data["x_values"] = x_values
        chart_data["y_values"] = y_values
        chart_data["title"] = title
        chart_data["x_label"] = x_label
        chart_data["y_label"] = y_label

        update_chart_bounds(chart_data, x_values, y_values, reference_line, reset_bounds=reset_bounds)

        canvas.update_idletasks()
        canvas.delete("all")

        W = canvas.winfo_width()
        H = canvas.winfo_height()

        if W < 10 or H < 10:
            return

        pad_l, pad_r, pad_t, pad_b = PLOT_PAD_L, PLOT_PAD_R, PLOT_PAD_T, PLOT_PAD_B

        min_x = chart_data.get("x_min", 0.0)
        max_x = chart_data.get("x_max", 1.0)
        min_y = chart_data.get("y_min", 0.0)
        max_y = chart_data.get("y_max", 1.0)

        if (not x_values or not y_values) and reference_line is None:
            canvas.create_text(
                W // 2,
                H // 2,
                text=empty_text,
                fill="gray",
                font=("Arial", 12)
            )
            return

        def tx(x):
            return pad_l + (x - min_x) / (max_x - min_x) * (W - pad_l - pad_r)

        def ty(y):
            return pad_t + (max_y - y) / (max_y - min_y) * (H - pad_t - pad_b)

        def format_axis_value(value):
            abs_value = abs(value)

            if value == 0:
                return "0"

            if abs_value < 0.01 or abs_value >= 10000:
                return f"{value:.2e}"

            return f"{value:.2f}"


        if reference_line is not None:
            ref_y = ty(reference_line)
            canvas.create_line(
                pad_l,
                ref_y,
                W - pad_r,
                ref_y,
                fill="#cc2222",
                dash=(4, 4),
                width=2,
                tags="refline"
            )

            label_text = reference_line_label or "Z0"
            canvas.create_text(
                W - pad_r - 10,
                ref_y - 10,
                text=f"{label_text} = {reference_line:.2f}",
                anchor="e",
                fill="#cc2222",
                font=("Arial", 8, "bold"),
                tags="refline"
            )


        if x_values:
            x_range = (max_x - min_x) or 1.0
            margin = x_range
            start_idx = bisect.bisect_left(x_values, min_x - margin)
            end_idx = bisect.bisect_right(x_values, max_x + margin)
            visible_x = x_values[start_idx:end_idx]
            visible_y = y_values[start_idx:end_idx]
        else:
            visible_x = x_values
            visible_y = y_values

        points = []
        last_px = None

        for x, y in zip(visible_x, visible_y):
            px = tx(x)

            # Pomijamy probki, ktore i tak wypadlyby w tym samym pikselu -
            # przy malym przyblizeniu/gestych danych mocno redukuje liczbe
            # punktow przekazywanych do canvasa.
            if last_px is not None and abs(px - last_px) < 1.0:
                continue

            last_px = px
            points.extend([px, ty(y)])

        if len(points) >= 4:
            canvas.create_line(
                points,
                fill="#2266cc",
                width=2,
                smooth=True,
                tags="content"
            )

        canvas.create_rectangle(0, 0, W, pad_t, fill="white", outline="", tags="mask")
        canvas.create_rectangle(0, H - pad_b, W, H, fill="white", outline="", tags="mask")
        canvas.create_rectangle(0, 0, pad_l, H, fill="white", outline="", tags="mask")
        canvas.create_rectangle(W - pad_r, 0, W, H, fill="white", outline="", tags="mask")

        canvas.create_text(
            W // 2,
            14,
            text=title,
            font=("Arial", 10, "bold"),
            tags="chrome"
        )

        canvas.create_line(
            pad_l,
            pad_t,
            pad_l,
            H - pad_b,
            width=2,
            tags="chrome"
        )

        canvas.create_line(
            pad_l,
            H - pad_b,
            W - pad_r,
            H - pad_b,
            width=2,
            tags="chrome"
        )

        canvas.create_text(
            W // 2,
            H - 12,
            text=x_label,
            tags="chrome"
        )

        canvas.create_text(
            14,
            H // 2,
            text=y_label,
            angle=90,
            tags="chrome"
        )

        steps = 5

        for i in range(steps + 1):
            y_val = min_y + i * (max_y - min_y) / steps
            y_pix = ty(y_val)

            canvas.create_line(
                pad_l - 4,
                y_pix,
                pad_l,
                y_pix,
                tags="chrome"
            )

            canvas.create_text(
                pad_l - 8,
                y_pix,
                text=format_axis_value(y_val),
                anchor="e",
                font=("Arial", 8),
                tags="chrome"
            )

            canvas.create_line(
                pad_l,
                y_pix,
                W - pad_r,
                y_pix,
                fill="#e0e0e0",
                dash=(2, 4),
                tags="chrome"
            )

        for i in range(steps + 1):
            x_val = min_x + i * (max_x - min_x) / steps
            x_pix = tx(x_val)

            canvas.create_line(
                x_pix,
                H - pad_b,
                x_pix,
                H - pad_b + 4,
                tags="chrome"
            )

            canvas.create_text(
                x_pix,
                H - pad_b + 14,
                text=format_axis_value(x_val),
                font=("Arial", 8),
                tags="chrome"
            )

    def redraw_from_state(canvas, chart_data, empty_text=""):

        draw_chart(
            canvas,
            chart_data,
            chart_data["x_values"],
            chart_data["y_values"],
            chart_data["title"],
            chart_data["x_label"],
            chart_data["y_label"],
            empty_text,
            reference_line=chart_data.get("reference_line"),
            reference_line_label=chart_data.get("reference_line_label")
        )

    def schedule_redraw(canvas, chart_data, delay=30):
        job = chart_data.get("redraw_job")
        if job is not None:
            canvas.after_cancel(job)

        def _do_redraw():
            chart_data["redraw_job"] = None
            redraw_from_state(canvas, chart_data)

        chart_data["redraw_job"] = canvas.after(delay, _do_redraw)

    def show_point_at_pixel(canvas, chart_data, px, py):
        W = canvas.winfo_width()
        H = canvas.winfo_height()
        pad_l, pad_r, pad_t, pad_b = PLOT_PAD_L, PLOT_PAD_R, PLOT_PAD_T, PLOT_PAD_B

        if not (pad_l <= px <= W - pad_r and pad_t <= py <= H - pad_b):
            return

        min_x = chart_data.get("x_min")
        max_x = chart_data.get("x_max")
        min_y = chart_data.get("y_min")
        max_y = chart_data.get("y_max")

        if min_x is None or max_x is None or min_y is None or max_y is None:
            return

        plot_w = W - pad_l - pad_r
        plot_h = H - pad_t - pad_b
        if plot_w <= 0 or plot_h <= 0:
            return

        x_values = chart_data.get("x_values") or []
        y_values = chart_data.get("y_values") or []

        if not x_values:
            return

        clicked_x = min_x + (px - pad_l) / plot_w * (max_x - min_x)

        idx = bisect.bisect_left(x_values, clicked_x)
        candidates = [i for i in (idx - 1, idx) if 0 <= i < len(x_values)]
        if not candidates:
            return

        best_i = min(candidates, key=lambda i: abs(x_values[i] - clicked_x))
        x_val = x_values[best_i]
        y_val = y_values[best_i]

        def tx(x):
            return pad_l + (x - min_x) / (max_x - min_x) * plot_w

        def ty(y):
            return pad_t + (max_y - y) / (max_y - min_y) * plot_h

        marker_px = tx(x_val)
        marker_py = ty(y_val)

        canvas.delete("marker")

        r = 4
        canvas.create_oval(
            marker_px - r, marker_py - r, marker_px + r, marker_py + r,
            outline="#009933", width=2, fill="white", tags="marker"
        )

        x_label = chart_data.get("x_label", "x")
        y_label = chart_data.get("y_label", "y")
        label = f"{x_label}: {x_val:.4g}\n{y_label}: {y_val:.4g}"

        is_left_half = marker_px < pad_l + plot_w / 2
        anchor = "nw" if is_left_half else "ne"
        offset_x = 8 if is_left_half else -8
        offset_y = 8 if marker_py < pad_t + plot_h / 2 else -34

        canvas.create_text(
            marker_px + offset_x, marker_py + offset_y,
            text=label,
            anchor=anchor,
            fill="#009933",
            font=("Arial", 8, "bold"),
            justify=tk.LEFT,
            tags="marker"
        )

    def on_mouse_wheel(event, canvas, chart_data):
        if chart_data.get("x_min") is None or chart_data.get("x_max") is None:
            return

        delta = getattr(event, "delta", 0)
        if delta == 0:
            if getattr(event, "num", None) == 4:
                delta = 120
            elif getattr(event, "num", None) == 5:
                delta = -120

        if delta == 0:
            return

        factor = 0.9 if delta > 0 else 1.1
        x_min = chart_data["x_min"]
        x_max = chart_data["x_max"]
        y_min = chart_data["y_min"]
        y_max = chart_data["y_max"]

        W = canvas.winfo_width()
        H = canvas.winfo_height()
        plot_w = W - PLOT_PAD_L - PLOT_PAD_R
        plot_h = H - PLOT_PAD_T - PLOT_PAD_B
        if plot_w <= 0 or plot_h <= 0:
            return

        px = min(max(event.x, PLOT_PAD_L), W - PLOT_PAD_R)
        py = min(max(event.y, PLOT_PAD_T), H - PLOT_PAD_B)
        center_x = x_min + (px - PLOT_PAD_L) / plot_w * (x_max - x_min)
        center_y = y_max - (py - PLOT_PAD_T) / plot_h * (y_max - y_min)

        new_width = max((x_max - x_min) * factor, 1e-12)
        new_height = max((y_max - y_min) * factor, 1e-12)

        chart_data["x_min"] = center_x - new_width / 2
        chart_data["x_max"] = center_x + new_width / 2
        chart_data["y_min"] = center_y - new_height / 2
        chart_data["y_max"] = center_y + new_height / 2

        schedule_redraw(canvas, chart_data, delay=16)

    def on_pan_start(event, canvas, chart_data):
        chart_data["pan_start"] = (event.x, event.y)
        chart_data["press_pos"] = (event.x, event.y)
        canvas.delete("marker")

    def on_pan_move(event, canvas, chart_data):
        if not chart_data.get("pan_start"):
            return

        x_start, y_start = chart_data["pan_start"]
        dx = event.x - x_start
        dy = event.y - y_start

        W = canvas.winfo_width()
        H = canvas.winfo_height()
        plot_w = W - PLOT_PAD_L - PLOT_PAD_R
        plot_h = H - PLOT_PAD_T - PLOT_PAD_B
        if plot_w <= 0 or plot_h <= 0:
            return

        x_range = chart_data["x_max"] - chart_data["x_min"]
        y_range = chart_data["y_max"] - chart_data["y_min"]

        chart_data["x_min"] -= dx / plot_w * x_range
        chart_data["x_max"] -= dx / plot_w * x_range
        chart_data["y_min"] += dy / plot_h * y_range
        chart_data["y_max"] += dy / plot_h * y_range

        chart_data["pan_start"] = (event.x, event.y)

        canvas.move("content", dx, dy)
        canvas.move("refline", 0, dy)
        schedule_redraw(canvas, chart_data, delay=40)

    def on_pan_end(event, canvas, chart_data):
        press_pos = chart_data.get("press_pos")
        chart_data["pan_start"] = None

        job = chart_data.get("redraw_job")
        if job is not None:
            canvas.after_cancel(job)
            chart_data["redraw_job"] = None

        redraw_from_state(canvas, chart_data)

        if press_pos is not None:
            moved = abs(event.x - press_pos[0]) + abs(event.y - press_pos[1])
            if moved <= 3:
                show_point_at_pixel(canvas, chart_data, event.x, event.y)

    def redraw_charts():
        draw_chart(
            raw_canvas,
            raw_data,
            raw_data["x_values"],
            raw_data["y_values"],
            raw_data["title"],
            raw_data["x_label"],
            raw_data["y_label"],
            "Press Load .csv"
        )
        draw_chart(
            impedance_canvas,
            impedance_data,
            impedance_data["x_values"],
            impedance_data["y_values"],
            impedance_data["title"],
            impedance_data["x_label"],
            impedance_data["y_label"],
            "Press Calculate Z(d)",
            reference_line=impedance_data.get("reference_line"),
            reference_line_label=impedance_data.get("reference_line_label")
        )

    def load_csv_data(filename):
        with open(filename, newline="") as csv_file:
            rows = list(csv.reader(csv_file))

        if len(rows) < 3:
            raise ValueError("CSV file has too few rows.")

        first_row = [cell.strip() for cell in rows[0]]
        second_row = [cell.strip() for cell in rows[1]]

        signal_name = first_row[1] if len(first_row) > 1 and first_row[1] else "Signal"
        x_label = second_row[0] if second_row and second_row[0] else "Sequence"
        y_label = "Voltage (V)"

        try:
            start_index = first_row.index("Start")
            increment_index = first_row.index("Increment")
            start = float(second_row[start_index])
            increment = float(second_row[increment_index])
            use_generated_x = True
            x_label = "Time (s)"
        except (ValueError, IndexError):
            start = 0.0
            increment = 1.0
            use_generated_x = False

        x_values = []
        y_values = []

        for row in rows[2:]:
            if len(row) < 2:
                continue

            try:
                sequence = float(row[0])
                value = float(row[1])
            except ValueError:
                continue

            x_values.append(start + sequence * increment if use_generated_x else sequence)
            y_values.append(value)

        if not x_values:
            raise ValueError("CSV file does not contain numeric data.")

        return x_values, y_values, f"{signal_name} vs {x_label}", x_label, y_label

    def get_loaded_csv():
        filename = csv_path.get()

        if not filename:
            messagebox.showwarning("No CSV selected", "Select a CSV file first.")
            return None

        print("Selected:", filename)

        try:
            return load_csv_data(filename)
        except (OSError, ValueError) as e:
            messagebox.showerror("CSV error", str(e))
            return None

    def on_load_csv():
        source = raw_selected_path_var.get()
        if not source:
            messagebox.showwarning("No file selected", "Select a file first.")
            return

        resolved_path = load_from_scope(source)
        if resolved_path is None:
            return
        csv_path.set(resolved_path)

        loaded = get_loaded_csv()
        if not loaded:
            return

        x_values, y_values, title, x_label, y_label = loaded

        # s -> ns conversion for time axis if applicable
        if x_label == "Time (s)":
            x_values = [x * 1e9 for x in x_values]
            x_label = "Time (ns)"

        draw_chart(
            raw_canvas,
            raw_data,
            x_values,
            y_values,
            title,
            x_label,
            y_label,
            "Press Load .csv",
            reset_bounds=True
        )

    def build_time_to_distance_converter(segments, default_vf, c):

        segs = sorted(segments, key=lambda s: s["start"])


        full_segments = []
        cursor = 0.0
        for seg in segs:
            if seg["start"] > cursor:
                full_segments.append({"start": cursor, "end": seg["start"], "vf": default_vf})
            full_segments.append({"start": seg["start"], "end": seg["end"], "vf": seg["vf"]})
            cursor = seg["end"]

        cum_time = 0.0
        segments_with_time = []
        for seg in full_segments:
            length = seg["end"] - seg["start"]
            one_way_time = length / (c * seg["vf"])
            segments_with_time.append({
                "start": seg["start"],
                "end": seg["end"],
                "vf": seg["vf"],
                "t_start": cum_time,
                "t_end": cum_time + one_way_time
            })
            cum_time += one_way_time

        def distance_from_roundtrip_time(dt_roundtrip):
            one_way_time = dt_roundtrip / 2.0

            if one_way_time <= 0 or not segments_with_time:
                return one_way_time * c * default_vf

            for seg in segments_with_time:
                if seg["t_start"] <= one_way_time <= seg["t_end"]:
                    dt_local = one_way_time - seg["t_start"]
                    return seg["start"] + dt_local * c * seg["vf"]

            last = segments_with_time[-1]
            dt_local = one_way_time - last["t_end"]
            return last["end"] + dt_local * c * default_vf

        return distance_from_roundtrip_time

    def prepare_tdr_data(times, voltages):
        c = 299792458.0

        try:
            z0 = float(z0_var.get())
            param_value = float(param_value_var.get())
            param_type = param_type_var.get()
        except ValueError:
            raise ValueError("Z0 and parameter value must be numeric.")

        if z0 <= 0:
            raise ValueError("Z0 must be greater than zero.")

        # er/Vf global conversion
        vf = param_to_vf(param_type, param_value)
        if param_type == "VF":
            er = 1.0 / (vf ** 2)  # er = 1 / vf^2
        else:
            er = param_value

        if len(times) < 2:
            raise ValueError("CSV file must contain at least two samples.")

        def average(values):
            return sum(values) / len(values)

        def find_first_above_threshold(values, start_index, threshold): #index of first sample above threshold
            for i in range(start_index, len(values)):
                if abs(values[i]) >= threshold:
                    return i
            return None

        def find_pulse_peak_and_end(values, start_index, noise_threshold): #index of peak and index of first sample below threshold after peak
            # Track the *first* excursion above the noise threshold, not the
            # single largest-magnitude sample anywhere in the rest of the
            # signal - a later spike/drift further down the trace must not
            # get mistaken for this pulse's peak.
            peak_index = start_index
            peak_magnitude = abs(values[start_index])
            end_index = len(values) - 1

            for i in range(start_index, len(values)):
                magnitude = abs(values[i])
                if magnitude < noise_threshold:
                    end_index = i
                    break
                if magnitude > peak_magnitude:
                    peak_magnitude = magnitude
                    peak_index = i

            return peak_index, end_index

        # Find the index of the first sample that is part of the pulse
        def find_impulse_index():
            if min(times) < 0 < max(times):
                for i, t in enumerate(times):
                    if t >= 0:
                        return i

            prelim_count = max(3, int(len(voltages) * 0.05))
            prelim_offset = average(voltages[:prelim_count])
            prelim_corrected = [v - prelim_offset for v in voltages]
            prelim_noise = average([abs(v) for v in prelim_corrected[:prelim_count]])
            prelim_peak = max(abs(v) for v in prelim_corrected)
            prelim_threshold = max(prelim_noise * 6, prelim_peak * 0.1, 1e-12)

            index = find_first_above_threshold(prelim_corrected, 0, prelim_threshold)
            return index if index is not None else prelim_count

        impulse_index = find_impulse_index()

        # removing baseline offset and calculating noise level
        baseline_samples = voltages[:impulse_index] if impulse_index >= 1 else voltages[:max(3, int(len(voltages) * 0.05))]
        voltage_offset = average(baseline_samples)
        corrected_voltages = [v - voltage_offset for v in voltages]
        noise_level = average([abs(v) for v in corrected_voltages[:len(baseline_samples)]])

        peak = max(abs(v) for v in corrected_voltages)
        noise_threshold = max(noise_level * 4, peak * 0.02, 1e-12)

        peak_index, pulse_end_index = find_pulse_peak_and_end(
            corrected_voltages, impulse_index, noise_threshold
        )

        calculation_start = min(pulse_end_index + 1, len(voltages) - 1)

        # find the incident voltage (the peak of the first pulse)
        incident_voltage = corrected_voltages[peak_index]

        if abs(incident_voltage) < 1e-12:
            raise ValueError("Incident pulse amplitude is too close to zero.")

        # find the index of the first sample that is part of the reflection pulse
        reflection_start_index = find_first_above_threshold(
            corrected_voltages, calculation_start, noise_threshold
        )

        if reflection_start_index is not None:
            reflection_peak_index, _ = find_pulse_peak_and_end(
                corrected_voltages, reflection_start_index, noise_threshold
            )
        else:
            reflection_peak_index = calculation_start

        # Cut at reflection_peak_index only tracks the *first* reflection's
        # extremum. For an open end that's near the end of the file anyway
        # (the reflection never decays back below the noise floor), but for
        # a short/matched end the signal dips, returns near baseline, and
        # the line keeps going - cutting at the dip discarded that tail.
        # Always show through the end of the file instead.
        plot_end_index = len(corrected_voltages) - 1

        return {
            "c": c,
            "z0": z0,
            "vf": vf,
            "er": er,
            "param_type": param_type,
            "times": times,
            "impulse_index": impulse_index,
            "peak_index": peak_index,
            "calculation_start": calculation_start,
            "reflection_peak_index": reflection_peak_index,
            "plot_end_index": plot_end_index,
            "voltage_offset": voltage_offset,
            "corrected_voltages": corrected_voltages,
            "incident_voltage": incident_voltage,
            "t0": times[peak_index]
        }

    def calculate_impedance_vs_distance(data):

        c = data["c"] # speed of light in vacuum [m/s]
        z0 = data["z0"] # reference impedance [Ohm]
        vf = data["vf"] # Velocity Factor for speed of light in the medium
        times = data["times"] # list of sample times [s]
        calculation_start = data["calculation_start"] # index of the first sample considered as reflection
        plot_end_index = data["plot_end_index"] # index of the end of the reflection pulse
        corrected_voltages = data["corrected_voltages"] # voltages after offset correction [V]
        incident_voltage = data["incident_voltage"] # incident voltage Vi, which is the peak of the first pulse [V]
        t0 = data["t0"]

        raw_segments = [
            {
                "start": seg["start"],
                "end": seg["end"],
                "vf": param_to_vf(seg["param_type"], seg["param_value"])
            }
            for seg in segments_list
        ]

        distance_from_roundtrip_time = build_time_to_distance_converter(raw_segments, vf, c)

        distances = []
        impedances = []

        reflection_times = times[calculation_start:plot_end_index + 1]
        reflection_voltages = corrected_voltages[calculation_start:plot_end_index + 1]

        for t, voltage in zip(reflection_times, reflection_voltages):
            gamma = voltage / incident_voltage #gamma = (Vr / Vi)
            gamma = max(min(gamma, 0.99), -0.99)  # Safty net for not dividing by 0

            distance = distance_from_roundtrip_time(t - t0) #distance = c * (t - t0) / (2 * vf) for every segment
            impedance = z0 * (1 + gamma) / (1 - gamma) #impedance = Z0 * (1 + gamma) / (1 - gamma)

            distances.append(distance)
            impedances.append(impedance)

        if not distances:
            raise ValueError("Could not calculate impedance from this CSV data.")

        return distances, impedances

    def on_calculate_zd():
        loaded = get_loaded_csv()
        if not loaded:
            return

        times, voltages, _, _, _ = loaded

        try:
            data = prepare_tdr_data(times, voltages)
        except ValueError as e:
            messagebox.showerror("Calculation error", str(e))
            return

        seg_summary = f"  segments={len(segments_list)}" if segments_list else ""
        info_text = (
            f"impulse_index={data['impulse_index']}  "
            f"peak_index={data['peak_index']}  "
            f"calc_start={data['calculation_start']}  "
            f"reflection_peak={data['reflection_peak_index']}  "
            f"plot_end={data['plot_end_index']}  "
            f"t0={data['t0']:.4e}s  "
            f"Voffset={data['voltage_offset']:.5f}V  "
            f"Vi={data['incident_voltage']:.5f}V"
            f"{seg_summary}"
        )
        info_var.set(info_text)
        print(info_text)

        try:
            distances, impedances = calculate_impedance_vs_distance(data)
        except ValueError as e:
            messagebox.showerror("Calculation error", str(e))
            return

        draw_chart(
            impedance_canvas,
            impedance_data,
            distances,
            impedances,
            "Impedance Profile",
            "Distance (m)",
            "Impedance (Ohm)",
            "Press Calculate Z(d)",
            reference_line=data["z0"],
            reference_line_label="Z0",
            reset_bounds=True
        )

    tk.Button(
        top_frame,
        text="Browse",
        width=14,
        command=browse_csv
    ).grid(row=0, column=1, sticky="new", padx=(0, 5), pady=(0, 4))

    tk.Button(
        top_frame,
        text="Load .csv",
        width=14,
        command=on_load_csv
    ).grid(row=0, column=2, sticky="new", pady=(0, 4))

    scope_combo = ttk.Combobox(
        top_frame,
        textvariable=scope_var,
        values=[SCOPE_RIGOL, SCOPE_RS],
        state="readonly",
        width=13
    )
    scope_combo.grid(row=1, column=1, sticky="new", padx=(0, 5))

    tk.Button(
        top_frame,
        text="Calculate Z(d)",
        width=14,
        command=on_calculate_zd
    ).grid(row=1, column=2, sticky="new")

    impedance_window.after(50, redraw_charts)

    impedance_window.bind(
        "<Configure>",
        lambda e: impedance_window.after(10, redraw_charts)
    )

    return impedance_window
