PioBudny/Engineer-s-Thesis/(commit log)

2025-05-14 altium i Datasheety 1
    [MSOP-8_K8-1_MCL.step, SY10EP11UKG.PcbLib, SY10EP11UKG.SchLib, Sheet1.SchDoc]
2025-05-19 Poprawki do schematu
    [Sheet1.SchDoc, TDR.PrjPcb]
2025-05-21 Dokończony schemat elektryczny
    [Sheet1.SchDoc, TDR.PrjPcb]
2026-01-15 Duży update z 3 miesięcy pracy
    [A4_TDR_Schematic_PB.SchDoc, PCB2.PcbDoc, TDR.PrjPcb, TDR2.PcbDoc, TDR_PCB_1.PcbLib, TDR_Sch_1.SchLib, TDR_Schematic_PB.SchDoc]
2026-01-19 schemat 19.01
    [MSOP-8_K8-1_MCL.step, SY10EP11UKG.PcbLib, SY10EP11UKG.SchLib, TDR_PCB_1.PcbLib, TDR_Sch_1.SchLib, TDR_Schematic_PB.SchDoc]
2026-02-11 TDR 3.0 Beta
    [8T49N241-999NLGI.SchDoc, PCB1.PcbLib, PCB2.PcbDoc, SamacSys.PcbLib, TDR.PrjPcb, TDR.SCHLIB, TDR3.PcbDoc, TDR_PCB_1.PcbLib]
2026-02-12 TDR3-wysłane do sprawdzenia
    [8T49N241-999NLGI.SchDoc, PCB1.PcbLib, PCB2.PcbDoc, SamacSys.PcbLib, TDR.SCHLIB, TDR3.PcbDoc, TDR_PCB_1.PcbLib, TDR_Sch_1.SchLib]
2026-03-07 Poprawki 07.03
    [8T49N241-999NLGI.SchDoc, Main.SchDoc, PCB1.PcbLib, SamacSys.PcbLib, TDR.PrjPcb, TDR.SCHLIB, TDR3.PcbDoc, TDR_PCB_1.PcbLib]
2026-03-08 Początek Pracy
    [PCB1.PcbLib, SamacSys.PcbLib, TDR.SCHLIB, TDR3.PcbDoc, TDR_Schematic_PB.SchDoc]
2026-03-18 Poprawki 18.02
    [8T49N241-999NLGI.SchDoc, Main.SchDoc, TDR3.PcbDoc, TDR_Schematic_PB.SchDoc]
2026-03-18 Poprawki 18.03 x2
    [TDR.PrjPcb, TDR3.PcbDoc]
2026-04-14 Wysłane do produkcji
    [8T49N241-999NLGI.SchDoc, TDR.PrjPcb, TDR3.PcbDoc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]
2026-05-27 próby z i2c
2026-06-16 Poprawki w kodzie, druga wersja sterowania GPIO
    [TDR3.PcbDoc]
2026-06-25 Testy 25.06
    [8T49N241-999NLGI.SchDoc]
2026-07-03 Impedance calclator
    [TDR_Schematic_PB.SchDoc]
2026-07-12 Kalkulator impedancji
    [Newfile1.csv, TDR3.PcbDoc, TDR_Schematic_PB.SchDoc, TDR_pulse_50-120-50_open_1.csv, Test.PcbDoc]
2026-07-14 Wersja stabilna, błędna odległość
    [test1.csv, test2.csv, test3.csv, test4.csv]
2026-07-16 Pico Control i pakowanie
2026-07-29 przed testami 29.07
    [8T49N241-999NLGI.SchDoc, Main.SchDoc, TDR_Schematic_PB.SchDoc]
2026-08-23 Poprawki stylistyczne
    [TDR_Schematic_PB.SchDoc]
